zmbya/air-filter-box/CAD/frame.FCStd

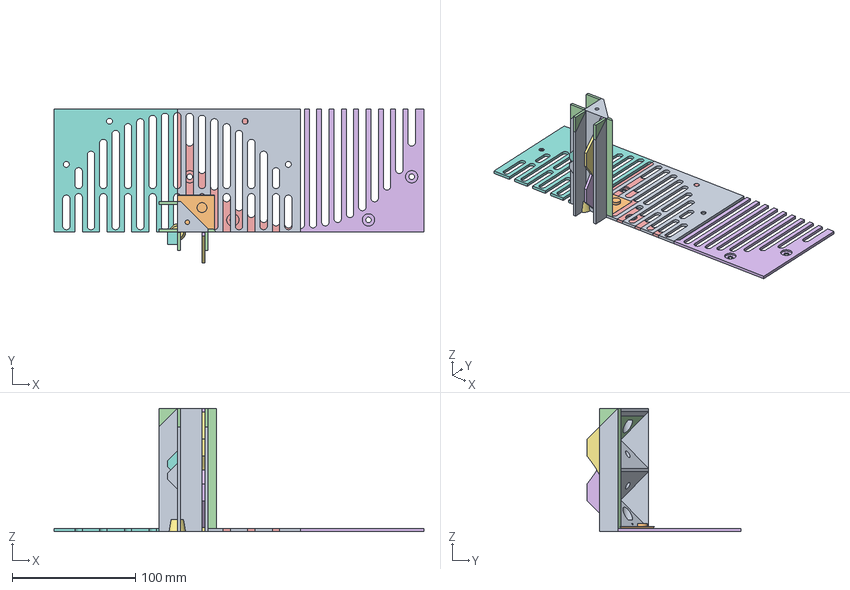
[picture p1: CAD file, 2026-10-09]
CAD/frame.FCStd
300.0 x 125.0 x 100.0 mm
corner
left-cutout
right-cutout
left-foot-cutout
right-foot-cutout
left-fan-cutout
right-fan-cutout
left-pcb
right-pcb
foot
panel-dc-jack
panel-pot
fan-cover-bl
fan-cover-br
pot-knob
fan-cover-v2-br
fan-cover-v2-bl
