zmbya/air-filter-box/CAD/v2/frame-v2.FCStd

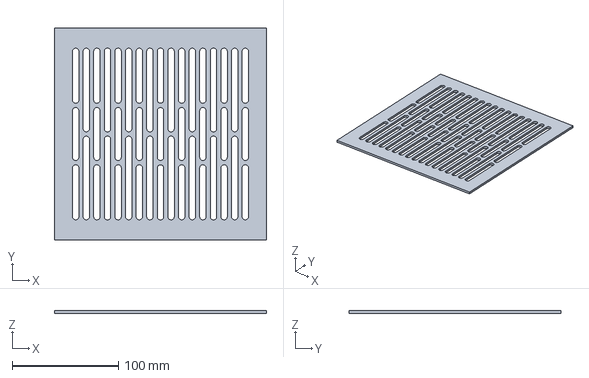
[picture p2: CAD file, 2026-10-09]
CAD/v2/frame-v2.FCStd
200.0 x 200.0 x 2.50 mm
