zmbya/air-filter-box/CAD/v2/prod/frame-v2-foot.step

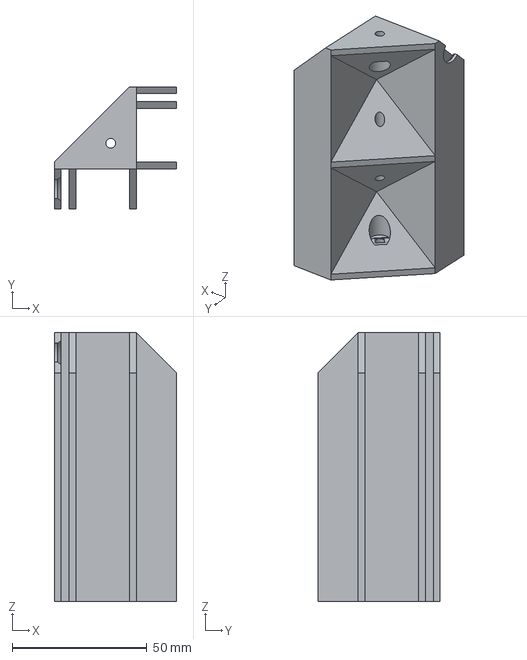
[picture p3: CAD file, 2026-10-09]
CAD/v2/prod/frame-v2-foot.step
45.5 x 45.5 x 100.0 mm
