zmbya/air-filter-box/EDA/board.step

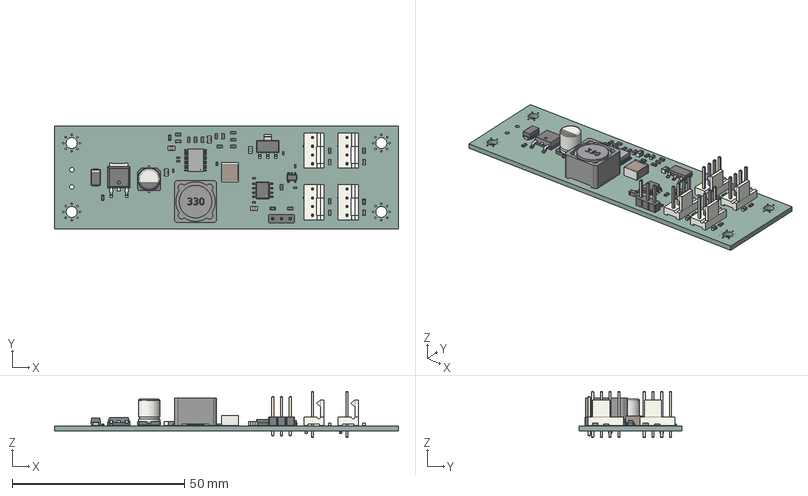
[picture p4: CAD file, 2026-10-07]
EDA/board.step
100.0 x 30.0 x 13.5 mm
C_0603_1608Metric x 7
R_0603_1608Metric x 17
Fan_Pin_Header_Straight_1x04 x 4
C_0402_1005Metric x 9
SOT-223
C_0805_2012Metric x 5
PinHeader_1x03_P254mm_Vertical
SOIC-8_3.9x4.9mm_P1.27mm
CP_Elec_63x77
SOT-23-5
C_2220_5750Metric
D_SMA
CQ assembly
932d09b2-9c39-11ed-93f0-dde97e994e83
932d09b3-9c39-11ed-93f0-dde97e994e83
932d09b3-9c39-11ed-93f0-dde97e994e83_part
932d09b4-9c39-11ed-93f0-dde97e994e83
932d09b4-9c39-11ed-93f0-dde97e994e83_part
932d09b5-9c39-11ed-93f0-dde97e994e83
932d09b5-9c39-11ed-93f0-dde97e994e83_part
air-filter-box_PCB
