zmbya/air-filter-box/CAD/potentiometer.FCStd

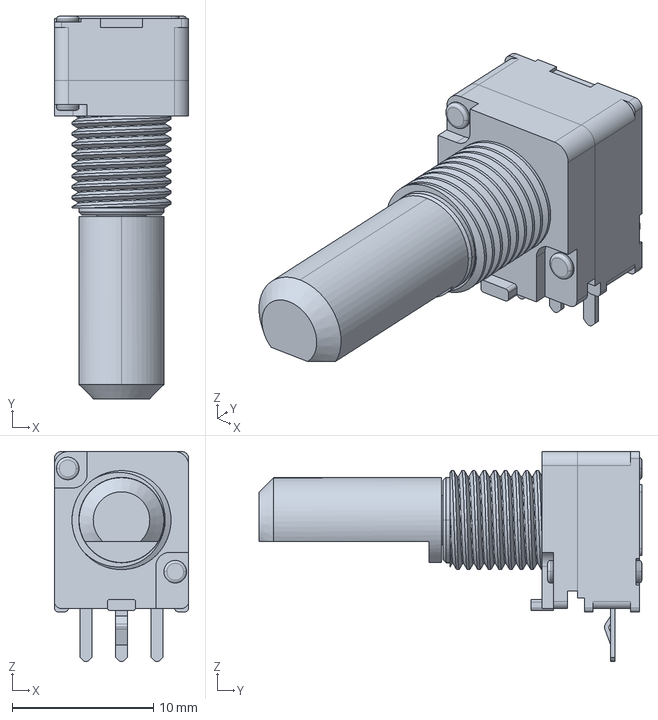
[picture p5: CAD file, 2026-10-07]
CAD/potentiometer.FCStd
9.50 x 27.1 x 14.8 mm
