zmbya/air-filter-box/CAD/v2/frame.FCStd

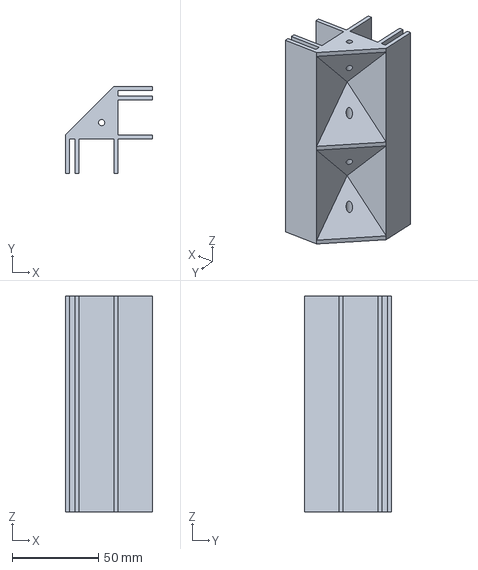
[picture p6: CAD file, 2026-10-09]
CAD/v2/frame.FCStd
50.5 x 50.5 x 125.0 mm
