zmbya/air-filter-box/CAD/v2/prod/frame-v2-filter-cover-tl.step

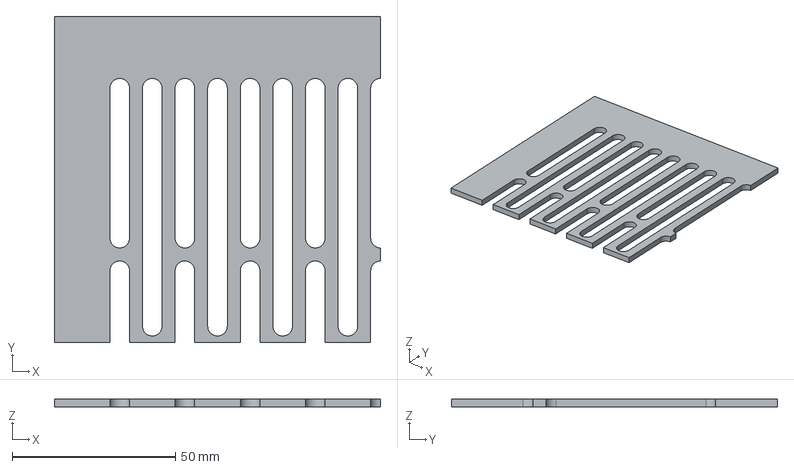
[picture p7: CAD file, 2026-10-09]
CAD/v2/prod/frame-v2-filter-cover-tl.step
100.0 x 100.0 x 2.50 mm
