zmbya/air-filter-box/CAD/fan.FCStd

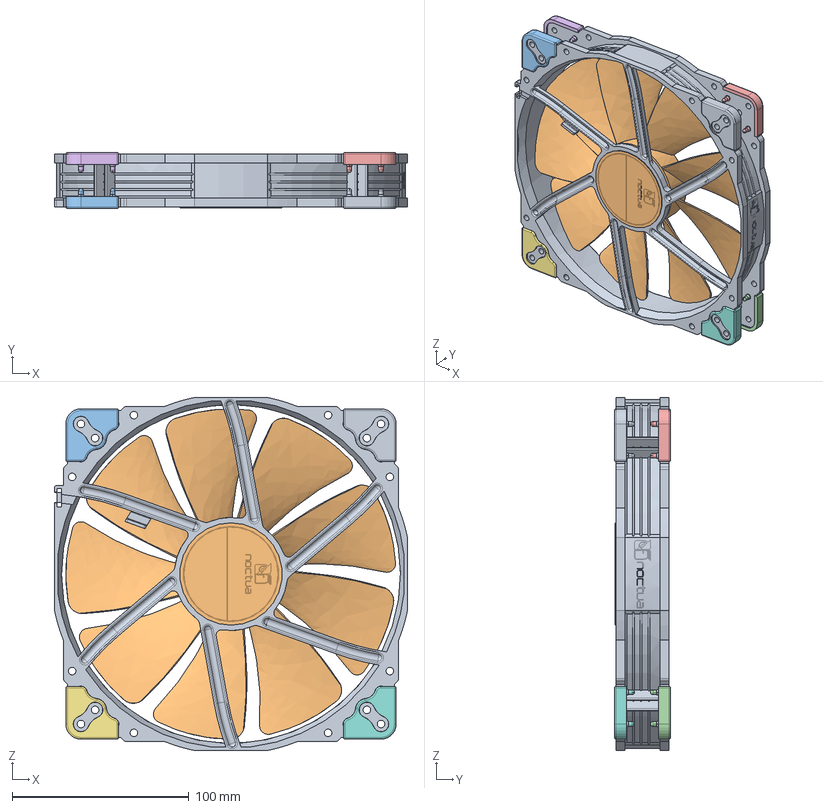
[picture p8: CAD file, 2026-10-07]
CAD/fan.FCStd
200.0 x 32.0 x 200.0 mm
NF-A20_Frame_Public
NF-A20_Impeller_Public
NA-AVP6
NA-AVP001
NA-AVP002
NA-AVP003
NA-AVP004
NA-AVP005
NA-AVP006
NF-A20_Lablel-Simple-JPEG
NA-AVP007
