zmbya/air-filter-box/CAD/v2/prod/print.3mf

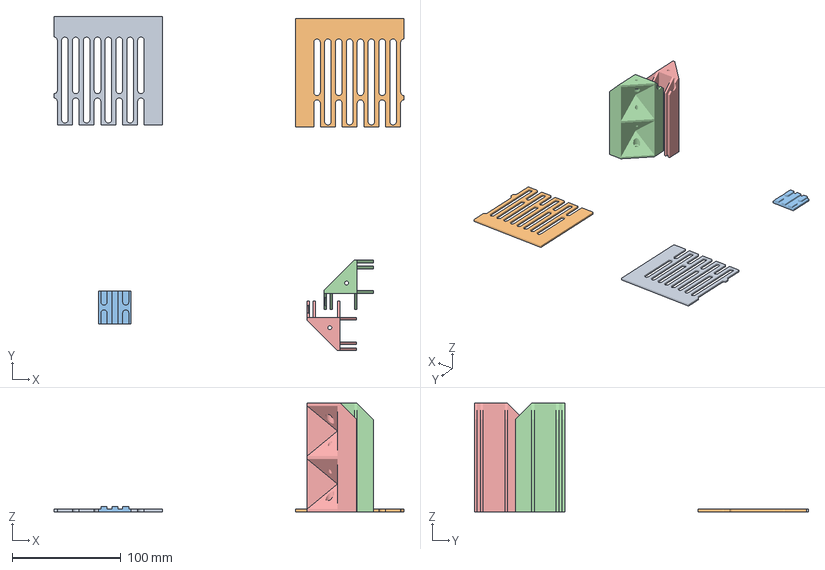
[picture p9: CAD file, 2026-10-09]
CAD/v2/prod/print.3mf
322.0 x 307.3 x 100.0 mm
frame-v2-filter-cover-tr.step
frame-v2-filter-cover-tl.step
frame-v2-filter-cover-clip.step
frame-v2-base-r.step x 2
