zmbya/air-filter-box/CAD/v2/prod/frame-v2-filter-cover-clip.step

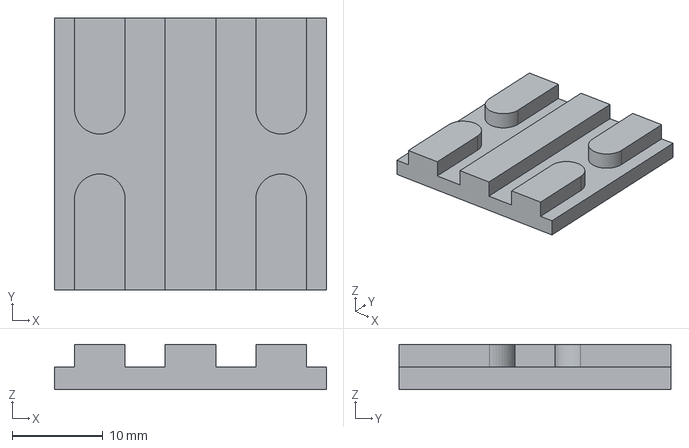
[picture p10: CAD file, 2026-10-09]
CAD/v2/prod/frame-v2-filter-cover-clip.step
30.0 x 30.0 x 5.00 mm
