zmbya/air-filter-box/(list of files, cad)

Other CAD files:
CAD/v2/prod/frame-v2-base-r.step
CAD/pcb.FCStd
CAD/v2/prod/frame-v2-filter-cover-tr.step
