zmbya/air-filter-box/EDA/schematic/buck-boost.pdf

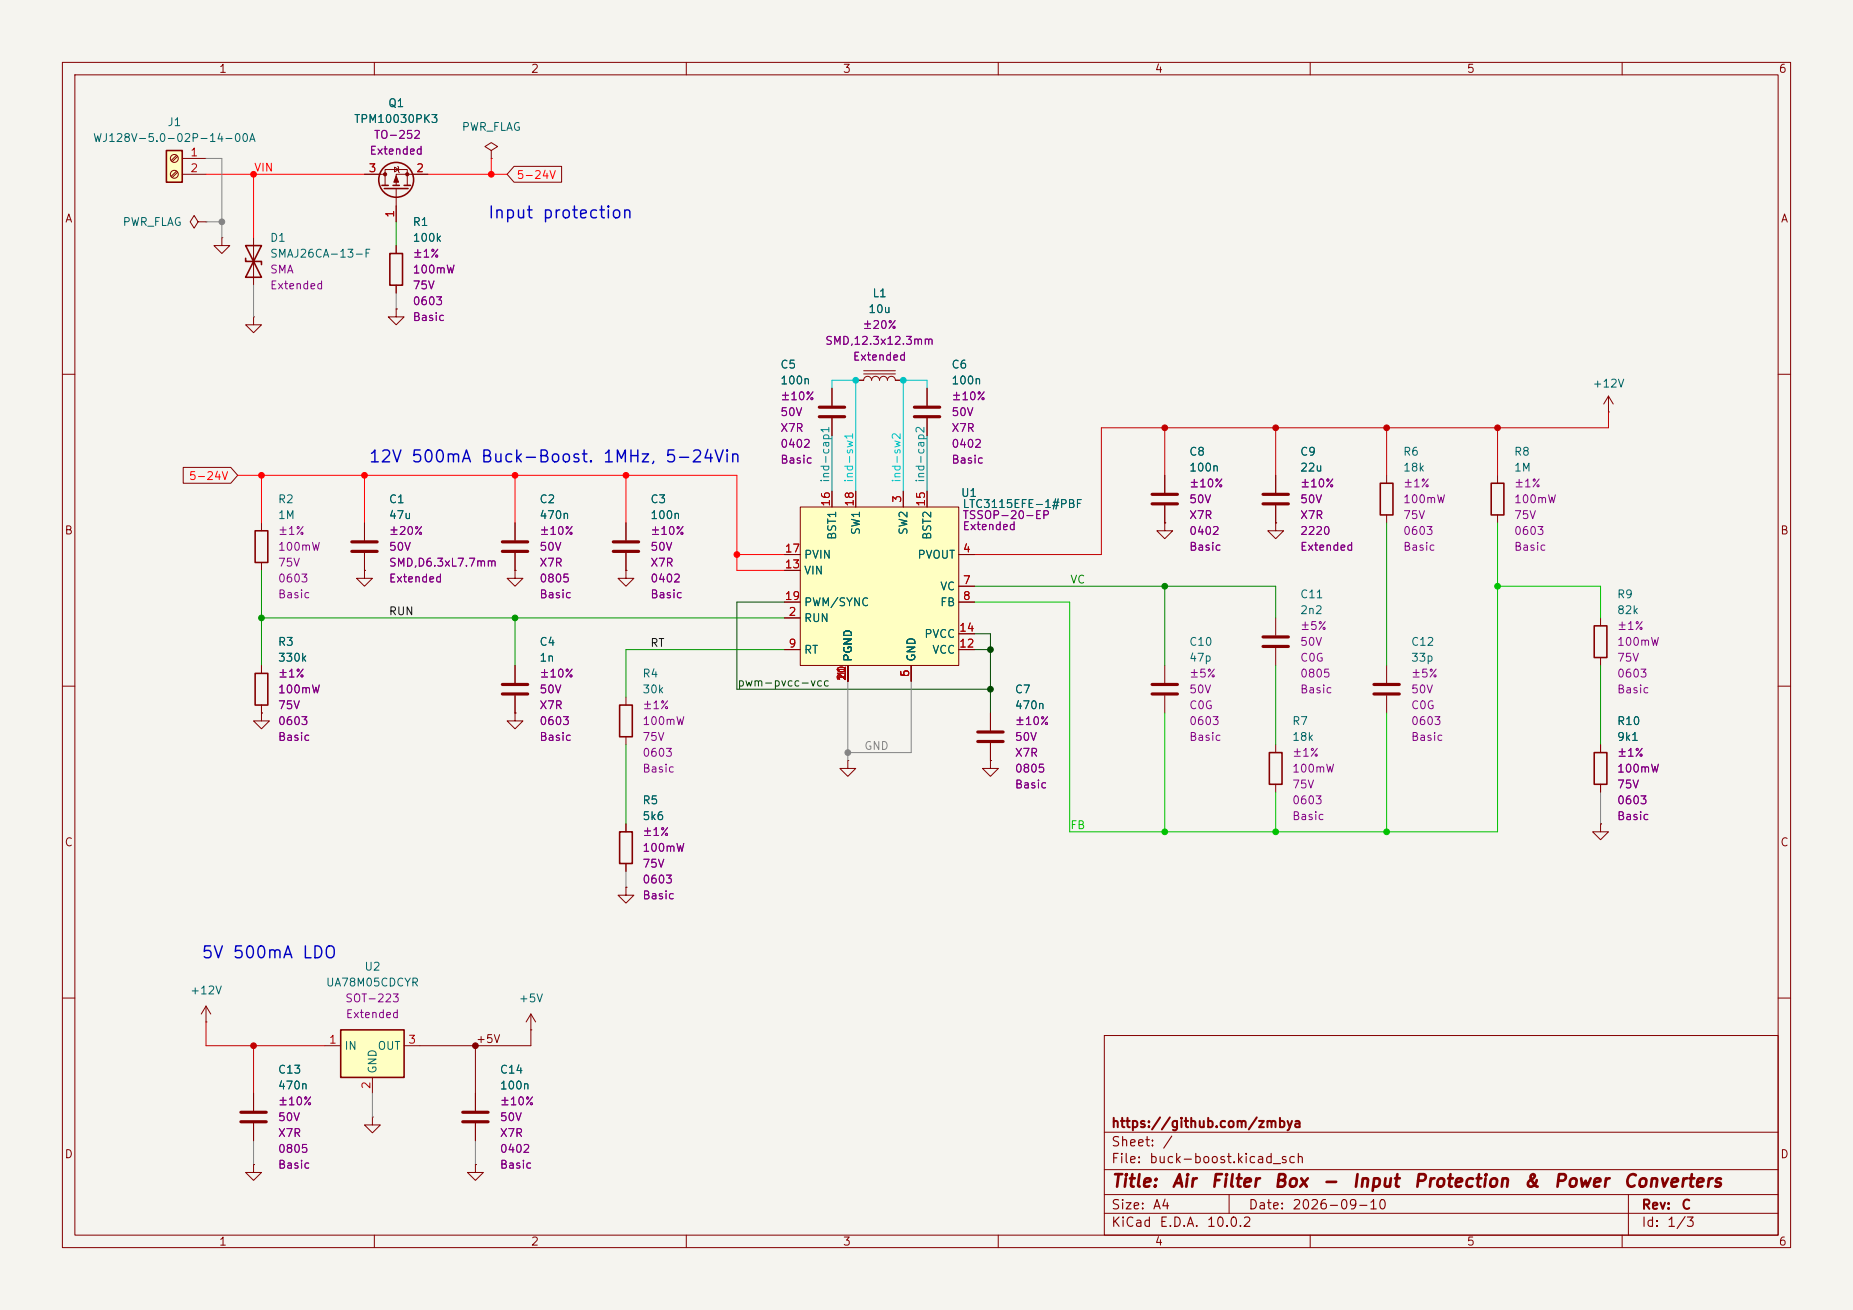
[picture p11: page 1]

pwm-pvcc-vcc 5V 500mA LDO

https://github.com/zmbya
Sheet: /
File: buck-boost.kicad_sch
Title: Air Filter Box - Input Protection & Power Converters

Size: A4 | Rev: C
KiCad E.D.A. 10.0.2 | Id: 1/3

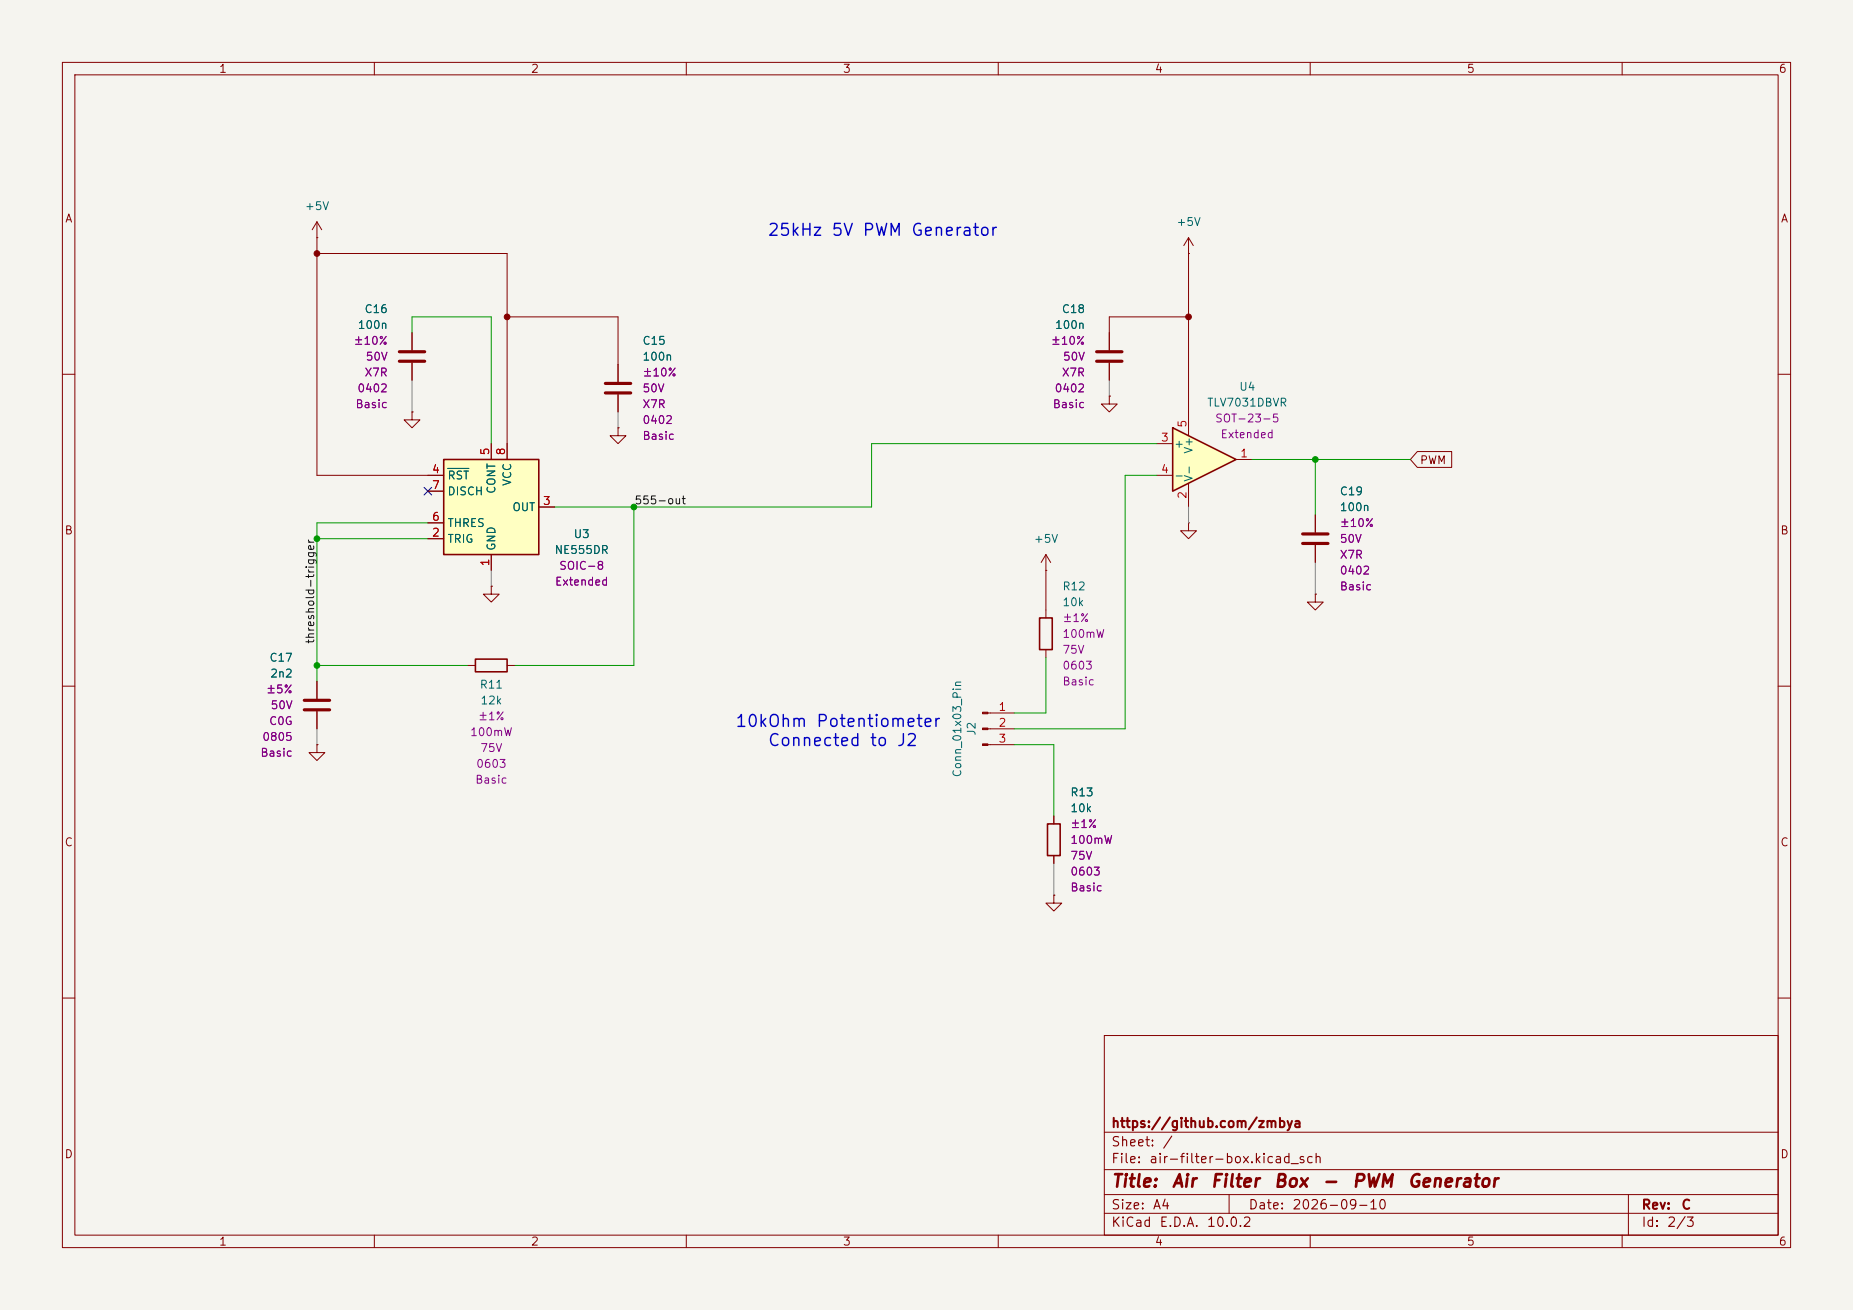
[picture p12: page 2]

https://github.com/zmbya
Sheet: /
File: air-filter-box.kicad_sch
Title: Air Filter Box - PWM Generator

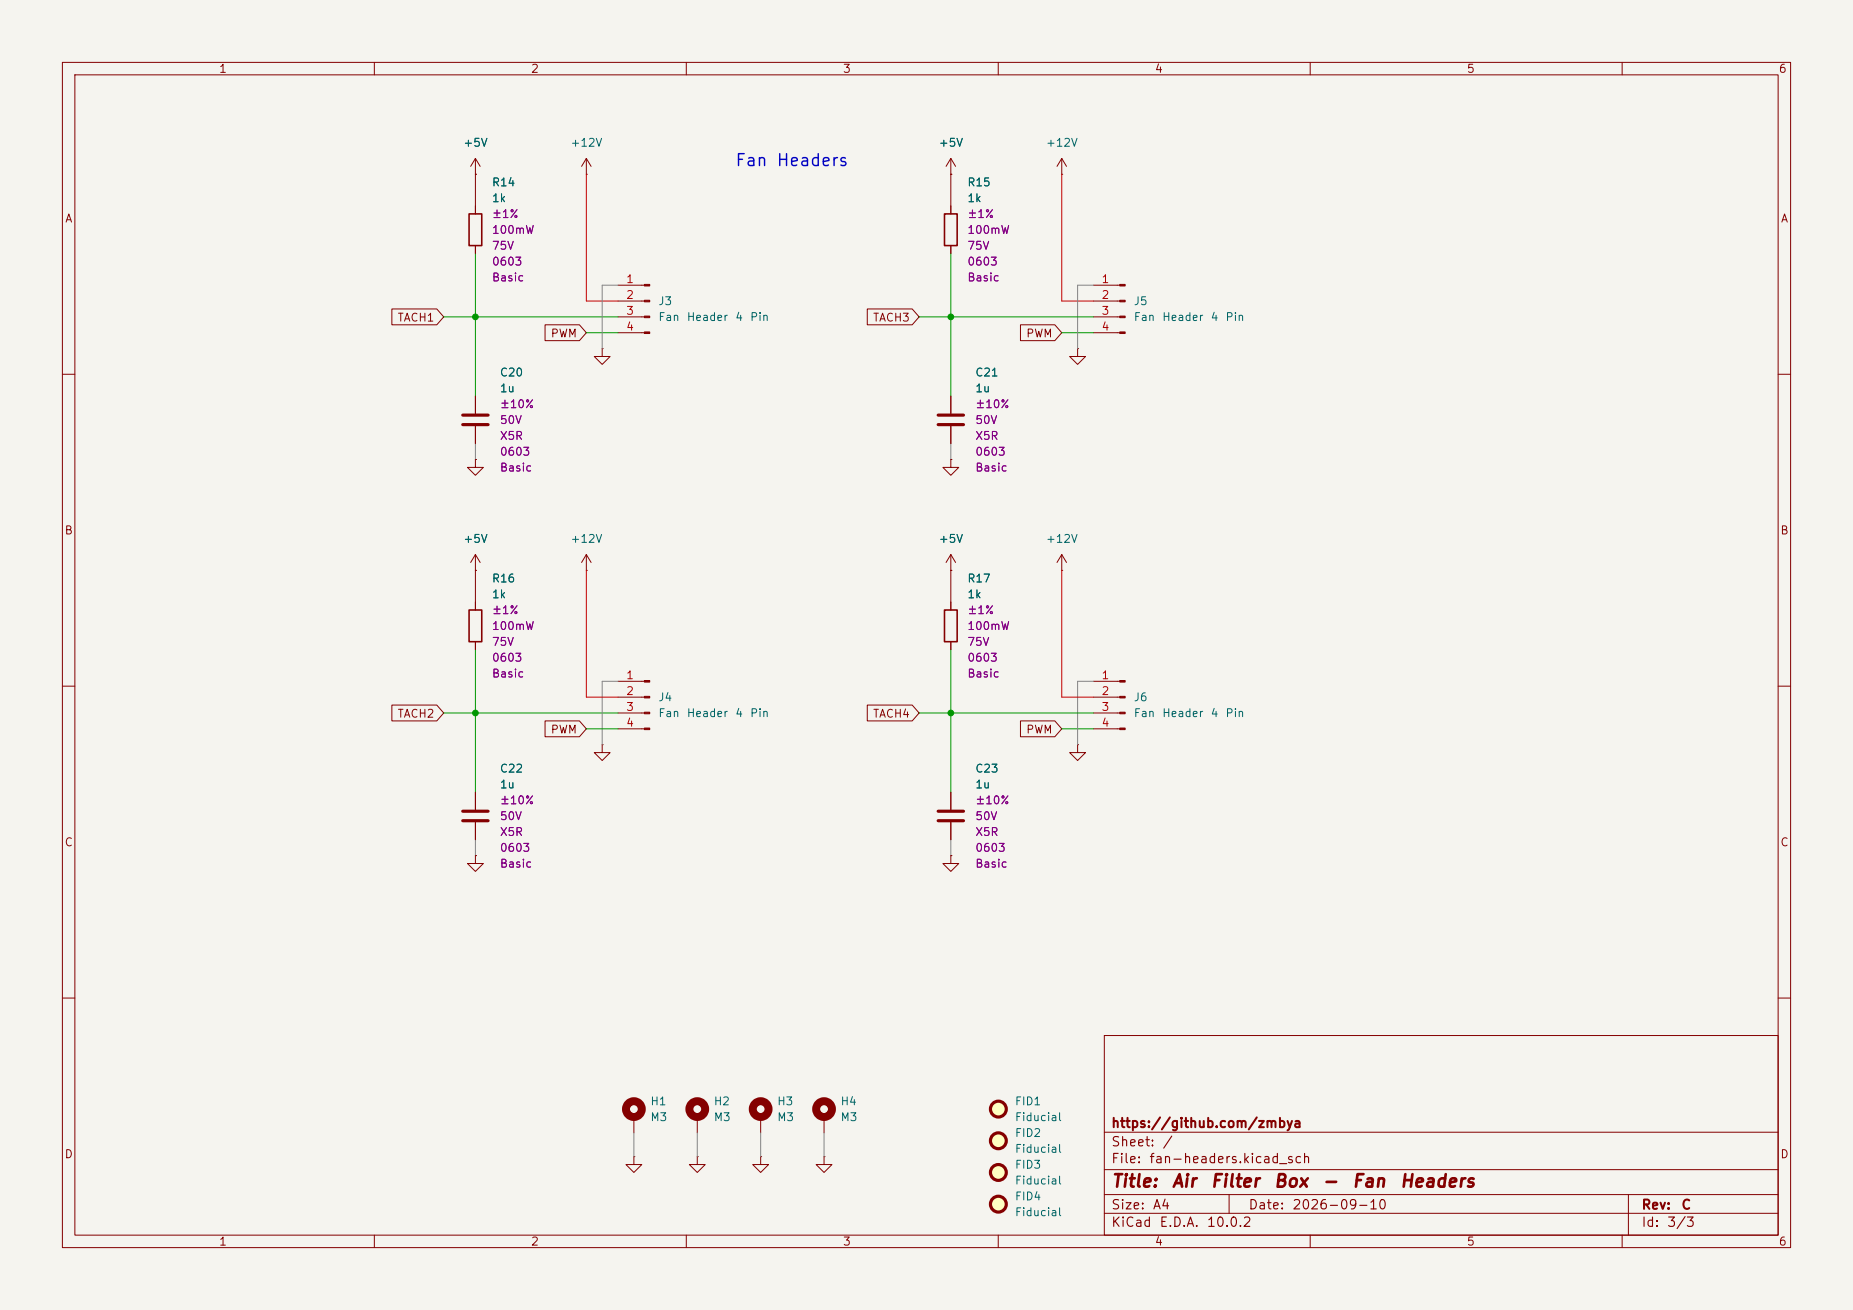
[picture p13: page 3]

https://github.com/zmbya
Sheet: /
File: fan-headers.kicad_sch
Title: Air Filter Box - Fan Headers
