zmbya/air-filter-box/EDA/simulation/lt3115-1-circuit-2.asc

C1: cap; 0.1µ
C2: cap; 0.1µ
C3: cap; 47µ
C4: cap; 22µ
C5: cap; {CFF}
C6: cap; {CFB}
C7: cap; {CPOLE}
C8: cap; 470n
C9: cap; 100n
I1: current; PULSE(0.5 0.00001 4.5m 10n 10n 1m 2m 1)
L1: ind; 10µ; Rser=30m
R1: res; 330k
R2: res; 1Meg
R3: res; 35.6k
R5: res; {RFF}
R6: res; {RTOP}
R7: res; 91.1k
R8: res; {RFB}
U1: LTC3115-1
V1: voltage; 30
Named nets: 0, Vc, FB
.tran 9m startup
.param RTOP = 1Meg
.param CFB = 2.2n
.param RFB = 18k
.param CPOLE = 47p
.param CFF = 33p
.param RFF = 18k
.softstart 0.5
