zmbya/air-filter-box/EDA/simulation/ltc3115-1-tf-boost.asc

C1: cap; {CFF}
C2: cap; {CFB}
C3: cap; {CPOLE}
E1: e; Laplace = GBOOST*((1+s/(2*pi*fZ))*(1-s/(2*pi*fRHPZ)))/((1+s/(2*pi*fo*Q)+(s/(2*pi*fo))**2))
E2: e; 1e6
E3: e; Laplace = GBOOST*((1+s/(2*pi*fZ))*(1-s/(2*pi*fRHPZ)))/((1+s/(2*pi*fo*Q)+(s/(2*pi*fo))**2))
R1: res; {RFF}
R2: res; {RTOP}
R3: res; {CFB}
R4: res; 90.9k
R5: res; 1g
V1: voltage; ""; AC 1
V3: voltage; 1000m
Named nets: 0, plant, comp, ac, casc
.ac dec 100 10 1meg
.param GBOOST=(29.7*VOUT**2)/VIN**2
.param fZ = (1/(2*pi*Rc*Co))
.param fRHPZ = ((R*(1-tLOW*f)**2*VIN**2)/(2*pi*L*VOUT**2))
.param fo = (1/(2*pi))*sqrt((Rs+(R*VIN**2)/VOUT**2)/(L*Co*(R+Rc)))
.param Q = (sqrt(L*Co*R*(Rs+(R*VIN**2)/VOUT**2))/(L+Co*Rs*R))
.param VOUT = 12
.param VIN=5
.param f = 1meg
.param tLOW = 90n
.param L = 10u
.param Rl = 27m
.param Co = 4.7u
.param Rc = 4m
.param Rs = Rl+300m
.param R=24
.param RTOP = 1Meg
.param CFB = 2.2n
.param RFB = 18k
.param CPOLE = 47p
.param CFF = 33p
.param RFF = 18k
