zmbya/air-filter-box/EDA/simulation/ltc3115-1-tf-buck.asc

C4: cap; {CFF}
C5: cap; {CFB}
C6: cap; {CPOLE}
E1: e; Laplace = GBUCK*(1+s/(2*pi*fZ))/(1+s/(2*pi*fo*Q)+(s/(2*pi*fo))**2)
E3: e; 1e6
E4: e; Laplace = GBUCK*(1+s/(2*pi*fZ))/(1+s/(2*pi*fo*Q)+(s/(2*pi*fo))**2)
R6: res; {RFF}
R7: res; {RTOP}
R8: res; {CFB}
R9: res; 90.9k
R10: res; 1g
V1: voltage; ""; AC 1
V3: voltage; 1000m
Named nets: 0, ac, plant, comp, casc
.param VOUT = 12
.param VIN=19
.param f = 1meg
.param tLOW = 90n
.param L = 33u
.param Rl = 65m
.param Co = 10u
.param Rc = 4m
.param Rs = Rl+300m
.param R = 50
.param GBUCK = 29.7*(R/(R+Rs))
.param fZ = (1/(2*pi*Rc*Co))
.param fo = 1/(2*pi)*sqrt((R+Rs)/(L*Co*(R+Rc)))
.param Q = sqrt(L*Co*(R+Rc)*(R+Rs))/(R*Rc*Co+L+Co*Rs*(R+Rc))
.ac dec 100 10 1meg
.param RTOP = 1Meg
.param CFB = 2.2n
.param RFB = 18k
.param CPOLE = 47p
.param CFF = 33p
.param RFF = 18k
