zmbya/air-filter-box/EDA/air-filter-box.kicad_pcb

## KiCad design EDA/air-filter-box.kicad_pcb (2026-10-07)

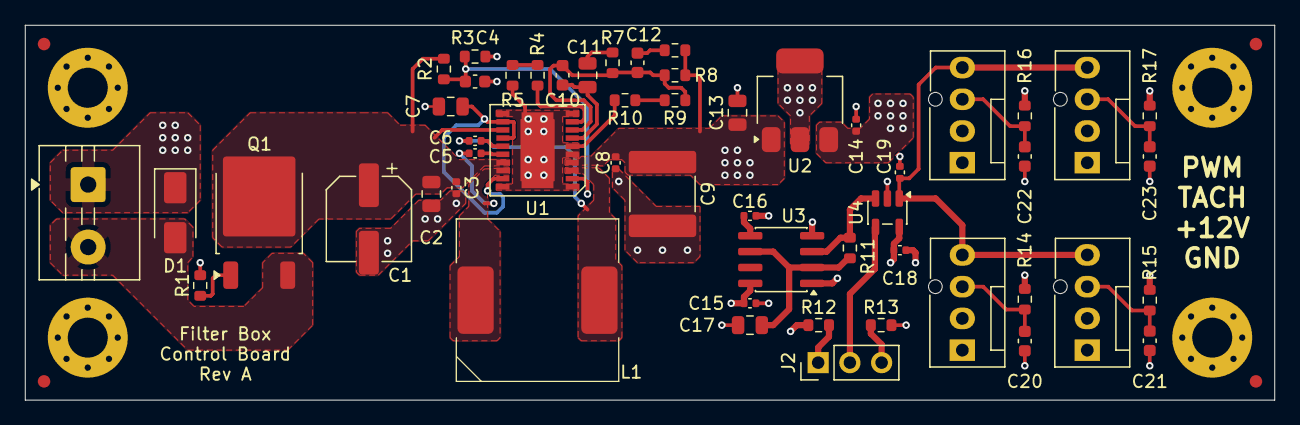
[picture p14: board air-filter-box.kicad_pcb from above]

Board: 4 copper layers, 100.0 x 30.0 mm, 61 parts (0 on the bottom side), 30 nets.

Parts:
C1: 47u; CP_Elec_6.3x7.7
C2, C7, C13: 470n; C_0805_2012Metric
C3, C5, C6, C8, C14, C15, C16, C18, C19: 100n; C_0402_1005Metric
C4: 1n; C_0603_1608Metric
C9: 22u; C_2220_5750Metric
C10: 47p; C_0603_1608Metric
C11, C17: 2n2; C_0805_2012Metric
C12: 33p; C_0603_1608Metric
C20, C21, C22, C23: 1u; C_0603_1608Metric
D1: SMAJ26CA-13-F; D_SMA
FID1, FID2, FID3, FID4: Fiducial; Fiducial_1mm_Mask2mm
H1, H2, H3, H4: M3; MountingHole_3.2mm_M3_Pad_Via
J1: WJ128V-5.0-02P-14-00A; TerminalBlock_MaiXu_MX126-5.0-02P_1x02_P5.00mm
J2: Conn_01x03_Pin; PinHeader_1x03_P2.54mm_Vertical
J3, J4, J5, J6: Fan Header 4 Pin; FanPinHeader_1x04_P2.54mm_Vertical
L1: 10u; SMDRI127-XXX-12.3-12.3-8.0
Q1: TPM10030PK3; TO-252-2
R1: 100k; R_0603_1608Metric
R2, R8: 1M; R_0603_1608Metric
R3: 330k; R_0603_1608Metric
R4: 30k; R_0603_1608Metric
R5: 5k6; R_0603_1608Metric
R6, R7: 18k; R_0603_1608Metric
R9: 82k; R_0603_1608Metric
R10: 9k1; R_0603_1608Metric
R11: 12k; R_0603_1608Metric
R12, R13: 10k; R_0603_1608Metric
R14, R15, R16, R17: 1k; R_0603_1608Metric
U1: LTC3115EFE-1#PBF; 20-lead-tssop-ep-lts-05-08-1663-ca
U2: UA78M05CDCYR; SOT-223-3_TabPin2
U3: NE555DR; SOIC-8_3.9x4.9mm_P1.27mm
U4: TLV7031DBVR; SOT-23-5

Connections:
5-24V: C1.1, C2.1, C3.1, Q1.2 (D), R2.1, U1.13 (VIN), U1.17 (PVIN)
+5V: C14.1, C15.1, C18.1, R12.1, R14.1, R15.1, R16.1, R17.1, U2.3 (OUT), U3.4 (~RST), U3.8 (VCC), U4.5 (V+)
+12V: C8.1, C9.1, C13.1, J3.2, J4.2, J5.2, J6.2, R6.1, R8.1, U1.4 (PVOUT), U2.1 (IN)
/555-out: R11.1, U3.3 (OUT), U4.3 (+)
/FB: C10.2, C12.2, R7.2, R8.2, R9.1, U1.8 (FB)
/RT: R4.1, U1.9 (RT)
/RUN: C4.1, R2.2, R3.1, U1.2 (RUN)
/VC: C10.1, C11.1, U1.7 (VC)
/VIN: D1.2 (A2), J1.2, Q1.3 (S)
/ind-cap1: C5.2, U1.16 (BST1)
/ind-cap2: C6.2, U1.15 (BST2)
/ind-sw1: C5.1, L1.1, U1.18 (SW1)
/ind-sw2: C6.1, L1.2, U1.3 (SW2)
/pwm-pvcc-vcc: C7.1, U1.12 (VCC), U1.14 (PVCC), U1.19 (PWM/SYNC)
/threshold-trigger: C17.1, R11.2, U3.2 (TRIG), U3.6 (THRES)
GND: C1.2, C2.2, C3.2, C4.2, C7.2, C8.2, C9.2, C13.2, C14.2, C15.2, C16.2, C17.2, C18.2, C19.2, C20.2, C21.2, C22.2, C23.2, D1.1 (A1), H1.1 (1_1), H2.1 (1_1), H3.1 (1_1), H4.1 (1_1), J1.1, J3.1, J4.1, J5.1, J6.1, R1.2, R3.2, R5.2, R10.2, R13.2, U1.1 (PGND), U1.5 (GND), U1.6 (GND), U1.10 (PGND), U1.11 (PGND), U1.20 (PGND), U1.21 (PGND), U2.2 (GND), U3.1 (GND), U4.2 (V-)
unnamed: C11.2, R7.1
unnamed: C12.1, R6.2
unnamed: J2.1, R12.2
unnamed: J2.2, U4.4 (-)
unnamed: J2.3, R13.1
unnamed: Q1.1 (G), R1.1
unnamed: R4.2, R5.1
unnamed: R9.2, R10.1
unnamed: C16.1, U3.5 (CONT)
PWM: C19.1, J3.4, J4.4, J5.4, J6.4, U4.1
TACH1: C20.1, J3.3, R14.2
TACH2: C22.1, J4.3, R16.2
TACH3: C21.1, J5.3, R15.2
TACH4: C23.1, J6.3, R17.2
