zmbya/air-filter-box/(commit log)

2026-10-07 exported schematic pdfs
2026-10-09 frame v2 base complete
    [frame-v2-base-r.step, frame-v2-filter-cover-clip.step, frame-v2-filter-cover-tl.step, frame-v2-filter-cover-tr.step, frame-v2-foot.step, frame-v2.FCStd, frame.FCStd, print.3mf]
